chrissavage2300/PIC-Digital-SMPS/PICSMPS_board.png

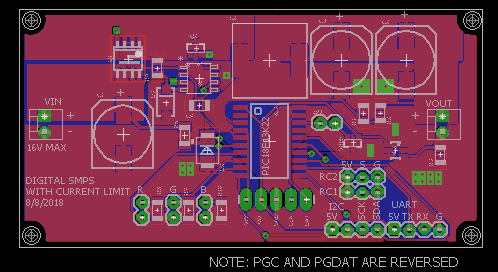
PICSMPS_board.png
