chrissavage2300/PIC-Digital-SMPS/BOM_SMPS_2018_08_10_A.xls

Part | Value | Device | Package | Description | Part # | Price
C1 | EEV337M035A9PAA | CPOL-US140CLH-1010 | 140CLH-1010 | Electrolytic Capacitor | 399-6715-1-ND (https://www.digikey.com/product-detail/en/kemet/EEV337M035A9PAA/399-6715-1-ND/3082846) | $0.84
C2 | EEV337M035A9PAA | CPOL-US140CLH-1010 | 140CLH-1010 | Electrolytic Capacitor | 399-6715-1-ND (https://www.digikey.com/product-detail/en/kemet/EEV337M035A9PAA/399-6715-1-ND/3082846) | $0.84
C3 | EEV337M035A9PAA | CPOL-US140CLH-1010 | 140CLH-1010 | Electrolytic Capacitor | 399-6715-1-ND (https://www.digikey.com/product-detail/en/kemet/EEV337M035A9PAA/399-6715-1-ND/3082846) | $0.84
C4 | 100nF | CAP1206 | 1206 | Standard Ceramic Capacitor | 732-12118-1-ND‎ (https://www.digikey.com/product-detail/en/885342208004/732-12118-1-ND/9346138/?itemSeq=268991609) | $0.10
D2 | 5.1v | DIODE-ZENERSMB | SMB-DIODE | 5.1V Zener Diode | 1SMB5918BT3GOSCT-ND (https://www.digikey.com/product-detail/en/on-semiconductor/1SMB5918BT3G/1SMB5918BT3GOSCT-ND/917721) | $0.53
D3 | MBR0520L | DIODE-SCHOTTKY-B340A | SMA-DIODE | Schottky diodes, SMA Package |  | $0.50 |  | STOCK
IC1 | MIC4604YM | MIC4604YM | SOIC-8_M | mic4604ym | 576-4396-1-ND (https://www.digikey.com/product-detail/en/microchip-technology/MIC4604YM-TR/576-4396-1-ND/4337048) | $0.73
IC2 | INA181A3 | INA181A3 | SOT23-6 | Current sense Amplifier, G=100 | 296-47658-1-ND (https://www.digikey.com/product-detail/en/texas-instruments/INA181A3IDBVR/296-47658-1-ND/8133027) | $0.58
IC3 | PIC18F13K22SOP | PIC18F13K22SOP | SOP20W | 18/20/28-Pin High-Performance, Enhanced Flash Microcontrollers |  | $1.80 |  | STOCK
JP1 | 2 Pin,0.1'' | M02POLAR_LOCK | MOLEX-1X2_LOCK | Standard 2-pin 0.1 header
JP2 | 2 Pin,0.1'' | M02POLAR_LOCK | MOLEX-1X2_LOCK | Standard 2-pin 0.1 header
JP3 | 2 Pin,0.1'' | M02PTH | 1X02 | Standard 2-pin 0.1 header
JP4 | ICSP,5 Pin,0.1'' | M05PTH_LONGPADS | 1X05_LONGPADS | Standard 5-pin 0.1 header
JP5 | 2 Pin,0.1'' | M02PTH | 1X02 | Standard 2-pin 0.1 header
JP6 | 2 Pin,0.1'' | M02PTH | 1X02 | Standard 2-pin 0.1 header
JP7 | 2 Pin,0.1'' | M02PTH | 1X02 | Standard 2-pin 0.1 header
JP8 | 4 Pin,0.1'' | M04LOCK | 1X04_LOCK | Standard 4-pin 0.1 header.
JP9 | 4 Pin,0.1'' | M04LOCK | 1X04_LOCK | Standard 4-pin 0.1 header.
JP10 | 3 Pin,0.1'' | M03LOCK | 1X03_LOCK | Standard 3-pin 0.1 header.
JP11 | 3 Pin,0.1'' | M03LOCK | 1X03_LOCK | Standard 3-pin 0.1 header.
L2 | 27uH,5A | SRR1210-680M | IND_BOURNS_SRR1210 | 27uH,5A,40mOhm Inductor | SRR1210-270MCT-ND (https://www.digikey.com/product-detail/en/bourns-inc/SRR1210-270M/SRR1210-270MCT-ND/2793212) | $1.26 |  | STOCK
Q1 | DMN3018SSS-13 | N-MOSFET-SO8S | SO-08 | N-Channel MOSFET | ‎DMG4466SSS-13DICT-ND‎ (https://www.digikey.com/product-detail/en/DMG4466SSS-13/DMG4466SSS-13DICT-ND/2334668/?itemSeq=268391039) | $0.50
Q2 | DMN3023 L | MOSFET-NCHANNELBSS123LT1G | SOT23-3 | Common NMOSFET Parts | DMN3023L-7DICT-ND (https://www.digikey.com/product-detail/en/diodes-incorporated/DMN3023L-7/DMN3023L-7DICT-ND/5453155) | $0.47
R1 | 2kΩ | RESISTOR1206 | 1206 | 2kΩ 1% | P2.0KBCCT-ND‎ (https://www.digikey.com/product-detail/en/ERA-8AEB202V/P2.0KBCCT-ND/3069645/?itemSeq=268990969) | $0.10
R2 | 8.08kΩ | RESISTOR1206 | 1206 | RES SMD 8.06K OHM 0.1% 1/4W 1206 | YAG2078CT-ND (https://www.digikey.com/product-detail/en/yageo/RT1206BRD078K06L/YAG2078CT-ND/5139526) | $0.68
R3 | 10mΩ | RESISTOR1206 | 1206 | 10mΩ | ‎408-1570-1-ND‎ (https://www.digikey.com/product-detail/en/KRL1632E-M-R010-F-T5/408-1570-1-ND/3737752/?itemSeq=268248021) | $0.54
R4 | 3Ω | RESISTOR1206 | 1206 | 3Ω | 311-3.00FRCT-ND (https://www.digikey.com/product-detail/en/yageo/RC1206FR-073RL/311-3.00FRCT-ND/731697) | $0.15
R6 | 1kΩ | RESISTOR1206 | 1206 | 1kΩ |  | $0.10 |  | STOCK
R8 | 200Ω | RESISTOR1206 | 1206 | 200Ω |  | $0.10
R9 | 200Ω | RESISTOR1206 | 1206 | 300 | 311-300FRCT-ND (https://www.digikey.com/product-detail/en/yageo/RC1206FR-07300RL/311-300FRCT-ND/731751) | $0.10 |  | STOCK
R10 | 200Ω | RESISTOR1206 | 1206 | 300 | 311-300FRCT-ND (https://www.digikey.com/product-detail/en/yageo/RC1206FR-07300RL/311-300FRCT-ND/731751) | $0.10 |  | STOCK
VREF | MCP1525/1541SOT | MCP1525/1541SOT | SOT23-3 | 2.5V Reference | MCP1525T-I/TTCT-ND (https://www.digikey.com/product-detail/en/microchip-technology/MCP1525T-I-TT/MCP1525T-I-TTCT-ND/1979817) | $0.79
PS1 | 15VDC Power Supply | 15VDC Power Supply,2.4A |  |  | LRS-35-15 (https://www.digikey.com/product-detail/en/mean-well-usa-inc/LRS-35-15/1866-3339-ND/7705039) |  | 12.65
 |  |  |  |  | Total | $11.65
