chrissavage2300/PIC-Digital-SMPS/SMPS_2018_09_04_A.brd

## EAGLE design SMPS_2018_09_04_A.brd (2018-09-05)

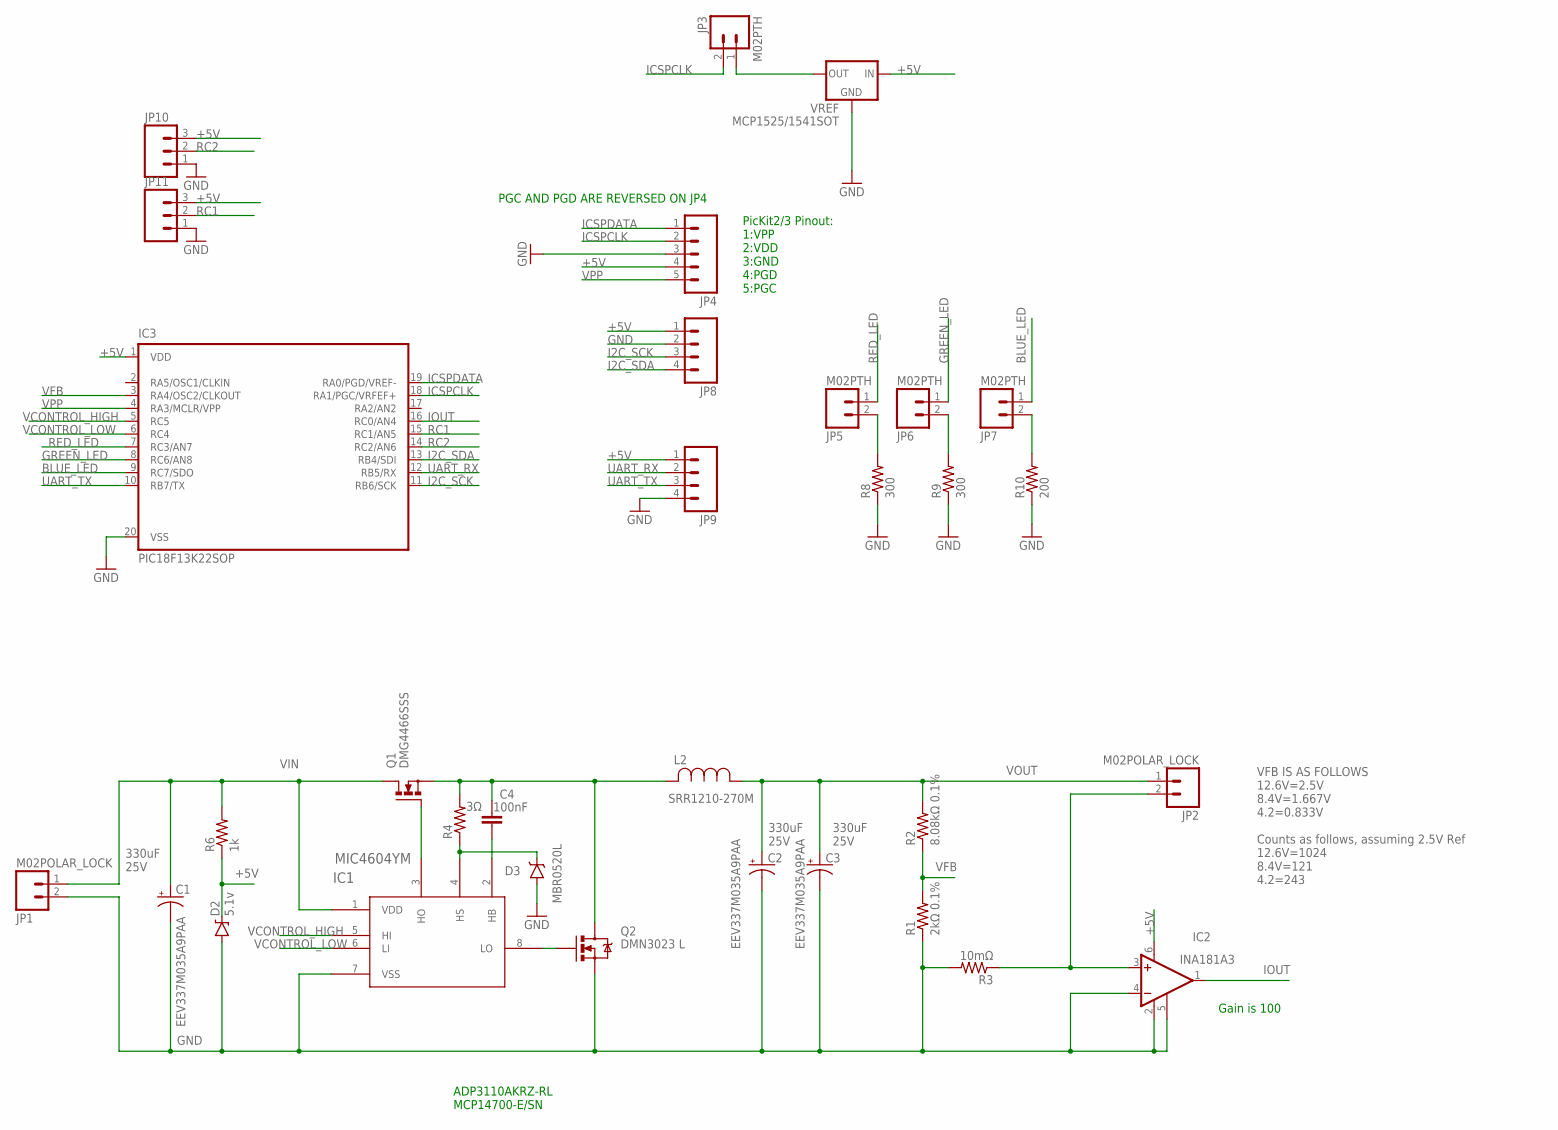
[picture p3: schematic SMPS_2018_09_04_A.sch]

Parts:
C1, C2, C3: EEV337M035A9PAA; 140CLH-1010
C4: 100nF; 1206
D2: 5.1v; SMB-DIODE
D3: MBR0520L; SMA-DIODE
IC1: MIC4604YM; SOIC-8_M
IC2: INA181A3; SOT23-6
IC3: PIC18F13K22SOP; SOP20W
JP1, JP2: M02POLAR_LOCK; MOLEX-1X2_LOCK
JP3, JP5, JP6, JP7: M02PTH; 1X02
JP4: M05PTH_LONGPADS; 1X05_LONGPADS
JP8, JP9: M04LOCK; 1X04_LOCK
JP10, JP11: M03LOCK; 1X03_LOCK
L2: SRR1210-270M; IND_BOURNS_SRR1210
Q1: DMG4466SSS; SO-08
Q2: DMN3023 L; SOT23-3
R1: 2kΩ 0.1%; 1206
R2: 8.08kΩ 0.1%; 1206
R3: 10mΩ; 1206
R4: 3Ω; 1206
R6: 1k; 1206
R8, R9: 300; 1206
R10: 200; 1206
VREF: MCP1525/1541SOT; SOT23-3

Connections:
+5V: D2.C, IC2.6 (V+), IC3.1 (VDD), JP4.4, JP8.1, JP9.1, JP10.3, JP11.3, R6.1, VREF.1 (IN)
BLUE_LED: IC3.9 (RC7/SDO), JP7.1
BORKED: IC2.3 (+IN), JP2.2, R3.1
GND: C1.-, C2.-, C3.-, D2.A, D3.A, IC1.7 (VSS), IC2.2 (GND), IC2.4 (-IN), IC2.5 (REF), IC3.20 (VSS), JP1.2, JP4.3, JP8.2, JP9.4, JP10.1, JP11.1, Q2.2 (S), R1.1, R3.2, R8.1, R9.1, R10.1, VREF.3 (GND)
GREEN_LED: IC3.8 (RC6/AN8), JP6.1
HIGHDRIVE: IC1.3 (HO), Q1.4 (G)
I2C_SCK: IC3.11 (RB6/SCK), JP8.3
I2C_SDA: IC3.13 (RB4/SDI), JP8.4
ICSPCLK: IC3.18 (RA1/PGC/VRFEF+), JP3.2, JP4.2
ICSPDATA: IC3.19 (RA0/PGD/VREF-), JP4.1
IOUT: IC2.1 (OUT), IC3.16 (RC0/AN4)
unnamed: C4.2, L2.2, Q1.1 (S), Q1.2 (S), Q1.3 (S), Q2.3 (D), R4.2
unnamed: JP5.2, R8.2
unnamed: C4.1, IC1.2 (HB)
unnamed: IC1.8 (LO), Q2.1 (G)
unnamed: JP6.2, R9.2
unnamed: JP7.2, R10.2
unnamed: D3.C, IC1.4 (HS), R4.1
RC1: IC3.15 (RC1/AN5), JP11.2
RC2: IC3.14 (RC2/AN6), JP10.2
RED_LED: IC3.7 (RC3/AN7), JP5.1
UART_RX: IC3.12 (RB5/RX), JP9.2
UART_TX: IC3.10 (RB7/TX), JP9.3
VCONTROL_HIGH: IC1.5 (HI), IC3.5 (RC5)
VCONTROL_LOW: IC1.6 (LI), IC3.6 (RC4)
VFB: IC3.3 (RA4/OSC2/CLKOUT), R1.2, R2.1
VIN: C1.+, IC1.1 (VDD), JP1.1, Q1.5 (D), Q1.6 (D), Q1.7 (D), Q1.8 (D), R6.2
VOUT: C2.+, C3.+, JP2.1, L2.1, R2.2
VPP: IC3.4 (RA3/MCLR/VPP), JP4.5
VREF+: JP3.1, VREF.2 (OUT)

Notes on the sheet:
ADP3110AKRZ-RL MCP14700-E/SN
Gain is 100
330uF 25V
VFB IS AS FOLLOWS 12.6V=2.5V 8.4V=1.667V 4.2=0.833V Counts as follows, assuming 2.5V Ref 12.6V=1024 8.4V=121 4.2=243
PicKit2/3 Pinout: 1:VPP 2:VDD 3:GND 4:PGD 5:PGC
PGC AND PGD ARE REVERSED ON JP4

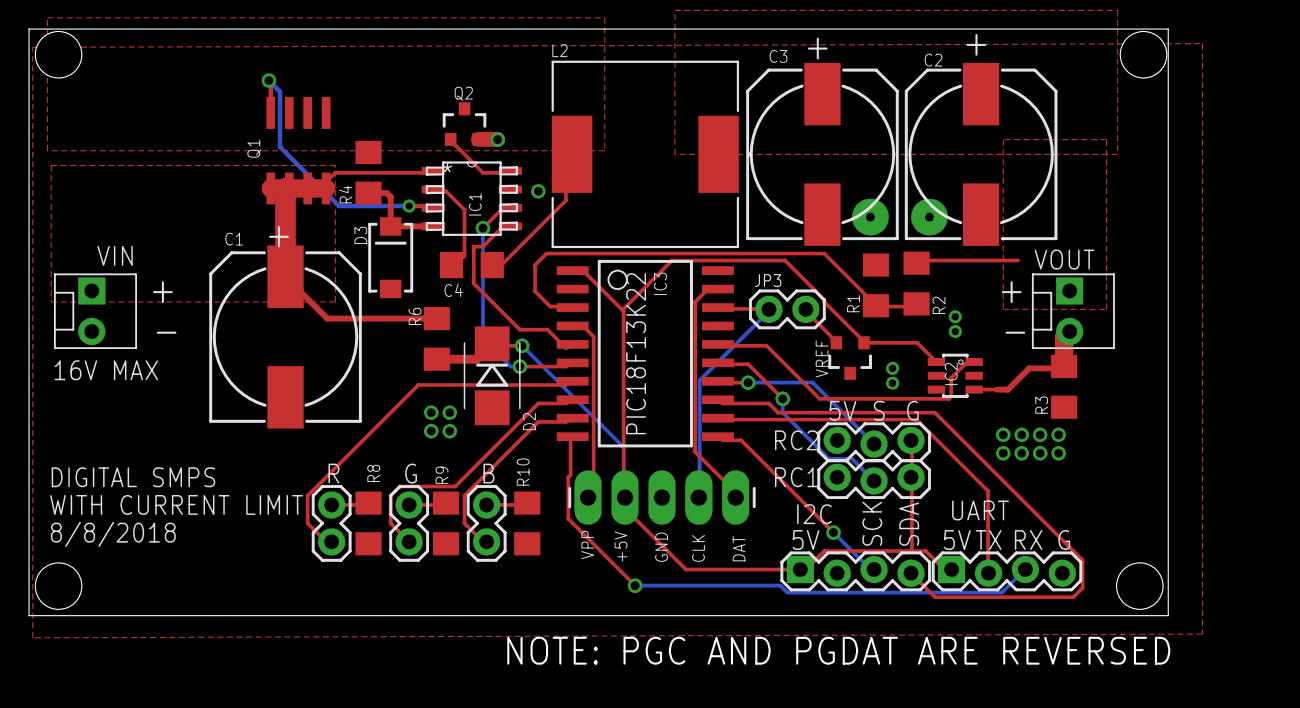
[picture p4: board SMPS_2018_09_04_A.brd from above]

Board: 2 copper layers, 78.4 x 40.4 mm, 32 parts (0 on the bottom side), 30 nets.
